andzhelo/DjDoorbell/videos/djdoorbell-reel-a/.thumbnails/v5_7471ff6d567243b7_d42bf97ba044923f_jpeg_source_index.html_1080x1920_1080x1920_1793446295449_0.00.jpg

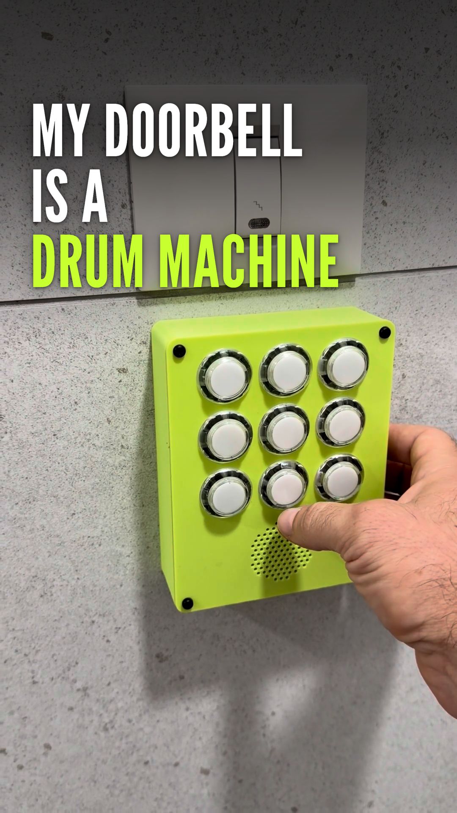
videos/djdoorbell-reel-a/.thumbnails/v5_7471ff6d567243b7_d42bf97ba044923f_jpeg_source_index.html_1080x1920_1080x1920_1793446295449_0.00.jpg
