andzhelo/DjDoorbell/docs/HANDOFF.md

# Handoff — build day

Written 2026-10-03, at the end of the first working session. Read this after
CLAUDE.md. It says where the project stands and what happens next, step by
step.

**How to work with the owner:** explain every step in plain words — what to
plug in, which command to run, what they should see. Hardware and CAD terms
need a one-line explanation the first time. When they ask for a short answer,
give one sentence. They plan to finish in **one day** and record it as a
**public video tutorial**, so steps should be filmable and in a sensible order.

---

## Where we are

| Area | State |
|---|---|
| Sounds | Done. 11 files in `data/raw/`, generated by `tools/make_samples.py`. Loop is exactly 64 grid steps (no drift). |
| Audio engine | Done, `lib/engine/`. Matches `tools/simulator.py` to 0.5 LSB. Repeat variant: pad 3 twice fast = open hat. |
| Outside bench firmware | Done, `src/main.cpp` (env `outside`). 9 pads, LED flash in row colour, quantised playback. Verified on the S3 with 5 buttons. |
| Link test | **PASSED** 2026-10-03, door closed, channel 1: unicast 99.987 %, longest gap 106 ms, RSSI −71 dBm. Log: `docs/linktest-2026-10-03.log`. |
| Two-board firmware | Written and **working on the bench**: presses play on both units on the same beat, sync within ±0.5 ms, zero late presses. Long-press pad 5 = chime (`11_chime`). WiFi + OTA on both (`*_ota` envs). Quiet hours done 2026-11-05 (web page card). Phone notification (ntfy) done 2026-11-05. Not yet done: replay. |
| Inside volume knob | **On** (`-DDJ_VOLUME_POT=1` in the `inside` env since 2026-11-05). 9 mm RV09 pot, ends on 3V3/GND, wiper GPIO34; verified on wall power. |
| Enclosure | Shell printed. Faceplate v2 (40 mm speaker) printing now. Sources in `cad/`. |
| Parts | All arrived. |
| Tests | `pio test -e native`: 30/30 (incl. a two-board sync simulation at ±300 ppm). |
| Repo | Public on GitHub. No LICENSE or README yet. |

## Facts a new session needs

- S3 serial port when on its **UART** USB socket: `/dev/cu.usbmodem5C834152081` (fourth S3, MAC B8:1F:3F:C3:D0:30, flashed 2026-10-30, healthy; this is the door board). Older: `/dev/cu.usbmodem5CF70341171` (second S3, see below). Third S3 `/dev/cu.usbmodem5CF70340961` (MAC 44:BD:8D:68:04:74) is parked with the pixel test on it. (second S3, MAC 44:BD:8D:68:03:A0 — USB power path damaged, ran from the buck; probably killed 2026-10-21 by 12 V on GPIO13 during the WS2815 build, see CLAUDE.md Power; new S3s on order; the first dead board was `/dev/cu.usbmodem5C843177861`). A third S3 is needed; see CLAUDE.md Power for the bench findings (outside amp dead, LED chain data path unverified).
  (a CH343 bridge). The other socket (native USB) flashes but shows no log.
  The WROOM's port: `/dev/cu.usbserial-0001` (CP2102).
- **WROOM bench quirk:** after a program closes its serial port, the WROOM
  sits in a reset loop (CP2102 auto-reset lines + macOS) and is silent until
  the port is reopened or USB is replugged. Keep a logger holding the port
  during bench tests. Irrelevant once installed (no USB).
- **WROOM screw-terminal adapter:** the terminal printed "GND" next to 5V is
  the board's **CMD** pin (flash). Use the GND between P13/P12 or bottom-right.
  All other labels match. Pins pushed into the terminals need the screws
  tightened.
- The first inside MAX98357A was **dead** (4.8 V at VIN, I2S running, no
  sound); replaced. Mark it.
- WiFi: use the main network `Andzhelo` (2.4 GHz on channel 1, "Smart
  Wi-Fi" on). The guest network refuses the S3 and isolates clients, so the
  Mac cannot reach the boards. Each board is refused once before joining
  (harmless). The S3 hears the router weakly (−87 dBm on the desk): OTA to
  the outside unit may need USB instead.
- **Power board simplified** (see CLAUDE.md Protection): fuse + 470 µF + buck
  only. Diagram and perfboard layout: https://claude.ai/artifact/9pFNN78vK4oG96C1DbZBHt
  Outside buck is set to 5.0 V and verified. Two earlier "dead" bucks were a
  broken adapter wire, not dead — they are probably fine.
- LED chain: soldered, passed the pixel test (needed the SS34 on its lead).
- Bench aids: type `1`-`9` / `c` on the S3 serial port to press a pad /
  chime; on the WROOM `c` = chime, `f` = full volume toggle. S3 BOOT = pad 5.
- To read serial without resetting or holding the port, the previous
  session used pyserial from PlatformIO's Python
  (`$(head -1 $(which pio) | sed 's/^#!//')`) with `dtr=False, rts=False`
  set before `open()`. Close the user's `pio device monitor` first or the
  port is busy.
- PlatformIO and OpenSCAD (snapshot cask) are installed via Homebrew.
  Homebrew's `python3` shadows the system one; the simulator needs
  `/usr/bin/python3` (it has numpy).
- Inside unit partitions: `min_spiffs.csv` (two 1.9 MB slots, for OTA). The
  next USB flash of the WROOM installs this layout.
- LED colours are gamma-corrected (`gamma8`) and capped at 40 %.
- Images from the owner often arrive as `.heic` in `~/Downloads`; convert
  with `sips -s format jpeg`. Video: extract frames with `ffmpeg`.

---

## Build day, in order

### 0. Faceplate (printing now)
When done: snap one button into a hole, slide one LED strip piece into a
channel, put the speaker in the ring, set the plate on the shell. All four
should fit without force.

### 1. Link test — the gate (~30 min)
Nothing gets soldered until this passes.

1. Plug **both** boards into the laptop. S3 on its UART socket.
2. Flash:
   ```sh
   pio run -e linktest_outside -t upload --upload-port /dev/cu.usbmodem5C843177861
   pio run -e linktest_inside  -t upload --upload-port <WROOM port>
   ```
3. Desk check, 30 s: open the inside monitor
   (`pio device monitor -p <WROOM port>`). Expect `outside unit found`,
   then a line every 10 s with near-zero loss. The S3's onboard LED is green.
4. Real test: WROOM stays on the laptop near the chime box. S3 goes
   outside where the button will be, on a phone power bank. **Close the
   door.** LED must be green.
5. Wait 10 minutes. The laptop prints `LINK TEST RESULT` and `OVERALL: PASS`
   or `FAIL`.
   - Pass criteria: unicast delivery ≥ 99.9 %, no silence ≥ 1 s,
     average RSSI ≥ −80 dBm.
6. **If FAIL:** stop and discuss. Options in order: move the inside board
   closer to the door, external-antenna board, or the Cat6 pull from
   CLAUDE.md (check for conduit).
7. Open question: the test uses WiFi channel 1. Once the inside unit joins
   home WiFi, ESP-NOW must run on the **router's** channel. Ask the owner
   for it; if known, rerun with `-DLINK_CHANNEL=<n>` added to both
   linktest envs.

### 2. Two-board firmware (Claude writes it; owner solders meanwhile)
Must-have for the day, in this order:
1. Outside: send each pad press to the inside unit over ESP-NOW (unicast),
   packet = pad index + grid position. Broadcast grid phase every bar.
2. Inside: same engine and samples, plays the events quantised to the same
   grid, locks to the outside's phase. A lost packet must not break sync.
3. Inside: volume pot on GPIO34 (ADC1).
4. Long-press centre pad (pad 5) = plain 2-second chime, both units.
5. WiFi + OTA on both units. Credentials in `include/secrets.h`
   (gitignored; template `include/secrets.example.h`).

Nice-to-have, if time allows: quiet hours (NTP, cut outside volume after
22:00), phone notification (MQTT or Home Assistant webhook), performance
replay.

Keep every new piece testable on the host like `lib/engine/`, and add
native tests.

### 3. Solder and assemble — outside unit
Do these **in this order**:

1. **LED strips first, on the bench.** Cut three 3-LED pieces at the copper
   pads. Solder them as one chain: row 1 out (right end) → row 2 in (left
   end) → row 3. Arrows left to right. Flash `outside_pixeltest`
   (`pio run -e outside_pixeltest -t upload`) and watch red/green/blue walk
   through all 9. Only then slide them into the channels.
2. **Set the buck converter to 5.0 V before connecting anything to it.**
   Feed it 12 V, turn its small screw while measuring the output with a
   meter. A wrong voltage here destroys the boards.
3. **Protection board** (perfboard), between the wall wires and the buck:
   wall + → fuse (500 mA — check the cap, the bag said 0313001, which may
   be 1 A) → SS34 (stripe towards the buck) → buck IN+.
   Across IN+/GND: SMAJ15A (stripe to +) and 470 µF (stripe to GND).
   Buck OUT+ → second SS34 (stripe away from buck) → **5 V rail** (~4.6 V).
4. 5 V rail → S3 5V pin, amp VIN, LED strip 5V. 1000 µF across 5V/GND at
   the first LED (stripe to GND).
5. Buttons: every COM to GND; NO to GPIO 4, 5, 6, 7, 15, 16, 17, 18, 8
   (pads 1–9, reading order).
6. Amp: BCLK→12, LRC→11, DIN→10, GAIN→VIN, SD not connected. Speaker on
   OUT+/OUT−, never to GND.
7. LED data: GPIO13 → 330 Ω → row 1 DIN.
8. Heat-set inserts into the 4 shell corners (soldering iron, slow and
   straight). Boards on the shell floor with foam tape. Plate on with
   4× M3×8 countersunk screws.

Inside unit wiring (in the existing chime box): amp BCLK→26, LRC→25,
DIN→22, GAIN not connected; pot ends to 3V3/GND, wiper → GPIO34. Power:
IRM-10-12 → 12 V → (a) the pair to the door, (b) buck at 5.0 V → SS34 →
WROOM 5V and amp VIN.

### 4. Install — **breaker off**
1. Breaker off. Confirm 0 V with the meter at the chime box before
   touching anything.
2. Remove the old chime and 8 V transformer. Mount the IRM-10-12 in its
   place. This is the 230 V step: if in any doubt, an electrician does it.
3. Mark which of the two brown wires is +12 V.
4. Breaker on. Measure 12 V DC on the pair **at the door, before**
   connecting the outside unit. Check polarity.
5. Connect the outside unit; screw the shell to the Nisko wall box
   (horizontal slots take 52–68 mm screw spacing).

### 5. Tune and publish
- Volume (inside pot; outside amp is already at its quiet gain), LED
  brightness, quantise on/off by ear.
- Before announcing the repo: add `LICENSE` (proposed: MIT for code,
  CC BY 4.0 for `cad/` and `data/` — confirm with the owner), a
  `README.md` for humans (what, photos/video, parts, wiring, build, flash,
  print), and a 230 V safety note. CLAUDE.md is for Claude, not readers.

---

## Open decisions

- Router WiFi channel: settled — both units join the router, so ESP-NOW
  follows its channel automatically.
- Fuse rating: confirm 500 mA.
- Idle LED behaviour: dark, dim breathing, or slow colour drift.
- Nisko wall-box screw spacing is assumed (60 mm); the slots allow 52–68.

## Tutorial (2026-10-31)

Public write-up of the whole build, with photos, clips, CAD renders and the
lessons: https://claude.ai/artifact/5YxCbNBJak7X3pdnc8jSSZ (private until shared
from its Share menu). Source page and media were generated from this repo's
`videos/djdoorbell/assets/` and `cad/preview/`.
