andzhelo/DjDoorbell/videos/djdoorbell/STORYBOARD.md

---
format: 1920x1080 (index.html) · 1080x1920 (reel.html)
duration: 159s · 39s
message: "A doorbell you play, not press"
arc: Hook (the finished pad) → The wall → Bench → Link test → Enclosure → Soldering → Assembly → At the wall → To be continued
audience: makers / DIY electronics
mode: autonomous
---

Both cuts are monolithic compositions (no sub-compositions): a flat video track cut on
the 124.016 BPM grid of the doorbell's own loop, chapter cards / captions as timed
overlays, and a persistent HUD (3x3 pad grid + 16-step bar) that pulses on the beat.
Generated by `generate.py`; edit the shot lists there or edit the HTML in Studio.

Motion citations: cold-open title and chapter cards = `kinetic-beat-slam`
(one BEAT/BAR grid drives every onset, distinct entrance per phrase: blur-slam /
side-snap / rise). Reel captions = `waterfall-entry`-style snap with a bar sweep.
HUD = finite per-beat `fromTo` pulses (no infinite repeats). Photos = Ken Burns on
an inner `<img>` (creator-editing-recipes → Pan / Ken Burns). Transitions: hard cuts on
the beat (percussive montage); chapter cards wipe in/out with `clip-path` — the wipe
is the exit. Final scene fades to black (allowed).

## Frame 1 — Cold open
- scene: Finished lime pad face-up; "DJ DOORBELL" slams on bar 1
- duration: 7.7s
- transition_in: cut
- status: animated
- src: index.html

## Frame 2 — 01 The wall
- scene: Old Nisko button, 230 V box, 8.18 V AC meter, transformer, pulling the old button
- duration: 15.5s
- status: animated
- src: index.html

## Frame 3 — 02 The bench
- scene: Parts, arcade button, S3 soldering, LED strip, breadboard, terminal board, buck
- duration: 19.4s
- status: animated
- src: index.html

## Frame 4 — 03 The gate
- scene: Link test: laptop on the floor, door closes, pad pressed outside
- duration: 15.5s
- status: animated
- src: index.html

## Frame 5 — 04 Enclosure
- scene: Coupon, shell, pressing buttons into the faceplate, nine buttons
- duration: 19.4s
- status: animated
- src: index.html

## Frame 6 — 05 Soldering
- scene: Power board, button wiring with smoke, two time-lapses, strip wiring
- duration: 34.8s
- status: animated
- src: index.html

## Frame 7 — 06 Assembly
- scene: Shell meets faceplate, pad face up, hero rotation
- duration: 19.4s
- status: animated
- src: index.html

## Frame 8 — 07 The wall, again
- scene: Bare wires in the wall, shell held against the wall
- duration: 15.5s
- status: animated
- src: index.html

## Frame 9 — End card
- scene: TO BE CONTINUED · Part 2: install day · GitHub URL; chime; fade
- duration: 11.6s
- status: animated
- src: index.html

## Reel — 10 shots × 2 bars
- scene: hero → old button → S3 → LEDs → door test → time-lapse → overhead → nine buttons → hero spin → at the wall
- duration: 38.7s
- status: animated
- src: reel.html
