andzhelo/DjDoorbell/(commit log)

2026-09-21 Scaffold PlatformIO project
    platformio.ini from CLAUDE.md verbatim, plus a native env for host unit
    tests and default_envs so a bare 'pio run' builds only the two boards.
    pioarduino stable installs Arduino-ESP32 core 3.3.12 (ESP_I2S API).
2026-09-21 Add audio engine and native quantiser tests
    Port of Engine from tools/simulator.py: looping bed, one retriggerable
    voice per pad, clock = samples rendered, strictly-next 16th quantise,
    same gains and tanh soft limit. Hardware-free so it runs on the host.
    Tests prove presses at arbitrary offsets and arbitrary render block
    sizes fire exactly on 2667-sample boundaries, both via the fire callback
    and in the rendered audio.
2026-09-21 Bench firmware: I2S out, embedded samples, BOOT button
    samples.{h,cpp} wrap the embed_files symbols as {data, len} and check
    2-byte alignment at boot. main.cpp logs chip/flash/PSRAM, runs the
    engine in an I2S-paced task on core 1 (clock = samples written), and
    queues 04_stab_am on each BOOT (GPIO0) press. Per-board I2S pins from
    the CLAUDE.md pin maps; mono written to both L and R slots.
2026-09-21 Log fire events from loop() instead of the audio task
    ets_printf on the audio task raced the Serial driver for UART0 and
    dropped characters. The fire callback now posts (pad, at) to a queue
    and loop() prints with Serial — the same hand-off LEDs and ESP-NOW
    will use. Also logs the full 64-bit sample count.
2026-09-21 Add pixel chain test env
    outside_pixeltest walks one pixel through 1-9 in red, green, then blue
    at 20% on GPIO13, logging each step. For checking the bench-soldered
    chain before any pixel is seated. The bench firmware is compiled out
    under PIXEL_TEST; outside/inside builds are unchanged.
2026-09-22 Add pad debouncer with native tests
    Accepts a level only after it holds for N ms, rejecting contact bounce
    and short spikes on long button wires. Hardware-free like the engine.
    Claude-Session: https://claude.ai/code/session_018jYxG8x3cBTVkduSsdmtGW
2026-09-22 Outside unit: nine pads, pixel flash, quantised playback
    Pads on GPIO 4 5 6 7 15 16 17 18 8 (INPUT_PULLUP, active low, 5 ms
    debounce). Each press logs its pad number and queues its sample; when
    it fires on the grid, that pad's pixel flashes in its row colour at the
    40% cap, delayed ~71 ms to match the I2S output latency. Inside unit
    keeps the BOOT-button bench test.
    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
2026-09-22 Gamma-correct pad row colours
    The row hex values are sRGB; WS2812 PWM is linear, so sent raw they
    over-drive green/blue and amber reads as warm white through a frosted
    cap. Decode with gamma8 before applying the 40% cap, and log the
    resulting LED values at boot.
    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
    [main.cpp]
2026-09-23 Regenerate sample set on the quantise grid
    The loop was 170709 samples (true 124 BPM) while the grid is 2667, so
    the quantiser drifted 21 samples per loop — 7.4 ms/min, audible after a
    few minutes. The generator now defines tempo from the grid (124.016 BPM)
    and the loop is exactly 64 x 2667 samples.
    Also: sub moved A1 -> A2 with more drive (55 Hz is inaudible on both
    speakers), bar 4 drops the last kick and adds a clap flam, Em stab
    replaced by F (i-III-VI instead of three chords sharing notes), and an
    open-hat variant (10_hat_open) for the repeat-variant feature. Generator
    and padboard now read/write data/raw; previews go to data/preview
    (ignored). Sample set is 557 KB.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
    [samples.cpp, samples.h]
2026-09-23 Engine: repeat variants and 1.0 limiter ceiling
    A press on the same pad within two grid steps plays the pad's variant
    if it has one; the firmware maps pad 3's repeat to the open hat. The
    limiter ceiling drops from 1.15 to 1.0: the old curve exceeded full
    scale at bed + two aligned hits and was hard-clipped. simulator.py
    mirrors both; the engine is sample-exact against it, including the
    variant path. Native tests: 13/13.
    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
2026-09-26 Add parametric OpenSCAD enclosure for the outside unit
    params.scad holds every dimension (MEASURE marks placeholders awaiting
    calipers). Parts: hole-size coupon (24.0/24.2/24.4), 100x145 faceplate
    with 3x3 pad grid, speaker grille and locating rib, and the shell with
    M3 insert bosses, wall-box slots, wire entry and board standoffs.
    render.sh exports STL + PNG via the CLI; output is gitignored.
    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
    [coupon.scad, faceplate.scad, params.scad, shell.scad]
2026-09-26 Coupon: 36 mm tiles so labels clear the hole
    On 30 mm tiles the last digit of 24.2/24.4 ran into the hole edge in
    the slicer. The larger tile puts the hole's lowest point 5.9 mm from
    the edge, clear of the label row, and gives a realistic margin around
    the 27.5 mm flange. Labels now read 24.0 rather than 24.
    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
    [coupon.scad]
2026-09-26 Coupon: 4 hole sizes x 2 panel thicknesses
    The real buttons are XW-OBSC (OBSC-24 clones): hole spec 24 +-0.1, no
    lamp holder, switch clipped under the clear body. FDM holes print
    undersize, so the range moves up to 24.0-24.6, and each is printed at
    2.5 and 3.0 mm to find the panel the snap tabs actually grip. README
    notes the LED now has to sit beside the switch block on a carrier.
    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
    [coupon.scad, params.scad]
2026-09-26 cad/README: switch is integral to the button body
    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
2026-09-26 params: button depths from the ruler photo
    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
    [params.scad]
2026-09-29 Faceplate and shell ready to print
    Coupon result 24.0/2.5 sets the hole and panel thickness. Shell depth
    from the measured button (terminals + 8 mm for wire bends), wall-box
    slots made horizontal to take 52-68 mm lug spacing, standoffs dropped
    (DevKitC-1 has no holes), and side-wall ledges added for the future LED
    carrier. The plate's locating rib is notched around the corner bosses;
    assembly.scad renders plate-on-shell and an interference check, which
    is empty.
    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
    [assembly.scad, faceplate.scad, params.scad, shell.scad]
2026-09-29 Side-lit buttons: LED strip channels on the faceplate back
    The switch block covers almost the whole button base, so under-lighting
    is out; a hand test confirmed side lighting through the clear body
    works. Each row gets an uncut 3-LED strip piece (100 mm) standing on
    edge in a channel just below it, LEDs up into the bodies. The plate and
    shell widen to 114 mm so the 100 mm strip fits inside the rib, and the
    unused carrier ledges are removed from the shell. assembly.scad now
    checks shell/plate, buttons/plate+strips and strips/plate+shell; all
    are empty, and deliberately clashing variants are caught.
    Claude-Session: https://claude.ai/code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
    [assembly.scad, faceplate.scad, params.scad, shell.scad]
2026-10-02 40 mm speaker; CLAUDE.md records hardware and enclosure decisions
    The speaker arrived at 40 mm, not 23.5: the faceplate gets a 42.8 mm
    ring and a 34 mm grille, centred between the bottom rib and the row-3
    strip fin, with asserts that fail the render on a clash. The shell is
    unchanged.
    CLAUDE.md now reflects what was decided since the spec was written:
    the real buttons (XW-OBSC, no lamp holder), side-lit rows with 3-LED
    strip pieces, the 114x145 enclosure, the glass fuse substitute, and
    build status, so a fresh session starts from the current state.
    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
    [faceplate.scad, params.scad]
2026-10-02 Inside unit: min_spiffs partitions for OTA updates
    huge_app.csv has a single 3 MB app slot, so the installed chime could
    only be updated over USB. min_spiffs.csv gives two 1.9 MB slots; the
    inside firmware with all samples is 880 KB (44.7%). CLAUDE.md updated
    with the reason and the 1.9 MB budget.
    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
2026-10-02 Phase 3 link test firmware (ESP-NOW gate)
    Outside sends 50 packets/s, alternating raw broadcast (no retries, raw
    radio loss) and unicast with MAC retries (what the doorbell will use),
    carrying its own delivery/echo/round-trip counters; its RGB LED is
    green while echoes arrive. Inside counts loss per kind from sequence
    numbers, RSSI and the longest silence, echoes every packet, prints a
    line every 10 s and a PASS/FAIL summary after 10 minutes: unicast
    delivery >= 99.9 %, no silence >= 1 s, average RSSI >= -80 dBm.
    Envs linktest_outside / linktest_inside; normal builds unchanged.
    Claude-Session: https://claude.ai/code/session_018jYxG8x3c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
    [link_test.cpp, main.cpp]
2026-10-03 Add build-day handoff
    docs/HANDOFF.md: current state, environment facts (ports, tooling),
    and the build day in order — link test, two-board firmware, soldering
    with polarity and the buck-voltage step, install with the breaker off,
    publishing. CLAUDE.md points to it.
    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
2026-10-03 Link test: score only the test window; passed through the door
    The sender's counters run across an inside reset, so failures from the
    inside reboot (~24 at 50 packets/s) were counted and would fail the
    0.1 % limit by themselves. The inside unit now subtracts the sender's
    counters from the first packet of the test. Also print the real STA MAC
    (WiFi.macAddress() read zeros before the radio started).
    Result 2026-10-03, door closed, channel 1: unicast 99.987 %, longest
    silence 106 ms, RSSI -71 dBm avg -> PASS. Log in docs/.
    Claude-Session: https://claude.ai/code/session_01L9EFyzyXBH3xgxpsxS9h4c
2026-10-03 Two-board firmware: inside follows the outside's grid over ESP-NOW
    Outside leads: every press goes to the inside unit (unicast, MAC retries
    plus two resends) with the musical position it sounds at; bed state goes
    10x/s while playing, 1x/s idle. Every packet carries the leader's
    position, so any packet can start or correct the follower.
    Inside follows 30 ms behind so a press always arrives before it is due,
    starts its bed at the leader's position, and locks to it by rendering one
    sample more or fewer per block when the filtered error leaves a 0.5 ms
    band (jump only past 50 ms). Simulated at +-300 ppm clock error with
    +-5 ms timing noise: worst 2.3 ms, every press on the leader's beat.
    Engin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
2026-10-03 Bench aids: type 1-9 / c on the outside serial port, BOOT = pad 5
    Status lines show the measured I2S rate (averaged since boot). First
    hardware run: presses reach the inside unit and fire on the same beat
    (identical sample spacing on both), sync error within +-10 samples,
    no late presses, no jumps. Drop the ADC attenuation call that logged an
    error (11 dB is already the default).
    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
2026-10-03 Inside: volume knob off by default (DJ_VOLUME_POT), fixed volume
    The bench pot read 0 V on GPIO34 whatever its position, which muted the
    inside unit. With DJ_VOLUME_POT=0 (default for now) the unit plays at
    kFixedVolumePct and ignores GPIO34; -DDJ_VOLUME_POT=1 brings the knob
    back. With the knob on, its reading is logged when it moves; 'f' on the
    serial port forces full volume, 'c' plays the chime.
    Verified on hardware: S3 pads play on both units.
    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
2026-10-03 Handoff: link test passed, two-board firmware on the bench, bench findings
    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
2026-10-03 CLAUDE.md: next step is soldering
    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
2026-10-06 Power board simplified: fuse + 470uF + buck, no SMD protection
    The SS34s and SMAJ15A were too hard to hand-solder on perfboard and none
    is critical. Recorded the costs (no reverse-polarity or USB back-feed
    protection) and the rules that replace them. LED chain passed the pixel
    test with an SS34 on its +5V lead; outside buck set to 5.0 V.
    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
2026-10-10 Outside: map pads to LEDs as built (rows 1 and 3 swapped)
    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
2026-10-10 CLAUDE.md: MP1584 trimmer is reversed; note the over-voltage incident
    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
2026-10-10 CLAUDE.md: outside S3 confirmed dead after over-voltage
    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
2026-10-19 Video: first-draft YouTube build montage and Instagram reel (HyperFrames)
    Two HyperFrames projects under videos/: djdoorbell (16:9, 2:39) and
    djdoorbell-reel (9:16, 39 s), both generated from videos/djdoorbell/generate.py
    with every cut on the doorbell loop's 124.016 BPM grid. Footage, renders and
    caches are gitignored; sources come from ~/Desktop/djdorbel_videos.
2026-10-19 Outside: 'd' serial command dumps raw pad levels; pixel test streams data and parks I2S pins
    - main.cpp: serial 'd' prints every pad GPIO and BOOT level for wiring checks.
    - pixel_test.cpp: resend each frame for the whole step so a meter on GPIO13
    reads ~0.5 V average (proves the board drives the chain); hold GPIO10-12
    low so an attached MAX98357A shuts down instead of roaring on pickup.
    Bench 2026-10-19 on the replacement S3: pads, I2S and pixel data all verified
    at the board; outside MAX98357A confirmed dead (spare plays); LED chain still
    unresponsive, first strip / data wire suspect.
    Claude-Session: https://claude.ai/code/sess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
2026-10-20 Docs: second S3 dead (regulator burned on a 3V3-powered strip test); amp dead; bench findings
    Claude-Session: https://claude.ai/code/session_01RBA2nmUtWJEMsY4GqEHdTW
2026-10-20 Docs: boards 2 and 3 alive on buck power (USB power path damaged); board 2 is the door board
    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
2026-10-21 CLAUDE.md: outside unit plays on board 2; 12 V WS2815 strip replaces the dead 5 V chain
    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
2026-10-21 Outside: pad->LED map as a per-pad table, 9 LEDs in reading order; docs: WS2815 attempt abandoned, board 2 likely dead
    The 12 V WS2815 chain worked as a 3-LED test but the full 9-LED build most
    likely put 12 V on GPIO13 (its +12V pad neighbours DI). Back to a 5 V 30/m
    WS2812B strip with the SS34 and the 330R series resistor. kPixelsOf keeps the
    per-pad table form so a backwards-chained row is a three-number edit.
    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
2026-10-30 Docs: fourth S3 flashed (port + MAC), 5 V strip arrived
    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
2026-10-30 CLAUDE.md: board 4 verified with the new strip; 5Vin jumper quirk; buck replaced
    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
2026-10-31 CLAUDE.md: outside unit fully verified on buck power (board 4, amp, 9 pads, 9 LEDs)
    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
2026-10-31 Outside: middle LED piece chained right-to-left, swap pads 4/6 in kPixelsOf
    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
2026-10-31 CLAUDE.md: IRM-10-12 installed; board 4 died on box close (mechanical short)
    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
2026-10-31 Docs: board 5 flashed with outside (port, MAC, IP); board 4 dead
    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
2026-10-31 CLAUDE.md: outside unit closed and working on board 5 after insulating all bare metal
    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
2026-10-31 CLAUDE.md: inside unit on wall power
    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
2026-10-31 CAD: inside unit enclosure (plate with 3" grille + shell for WROOM/buck/amp), parametric, MEASURE placeholders
    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
2026-10-31 CAD inside: mains compartment for the IRM-10-12 + connectors, partition, shell/fit checks
    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
2026-10-31 Reel A: vertical Instagram cut of the DJ Doorbell build, music from the doorbell's own engine
    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
2026-10-31 Reel A v4: clean start, maker centred in the soldering bar, levelled sound
    Hook and loop tail start at 8.03 s of the door clip (after a sound tail that
    opened v3 on a burst). The soldering bar uses the near-square clip with the
    maker centred. Hook audio gets a volume lane and a 90 Hz high-pass, bars 2-3
    of the generated track are filled out, chime sits under the music, and the
    delivery transcode is limited to -14.4 LUFS.
    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
2026-11-01 Inside enclosure: square 78 mm speaker on insert bosses, volume-knob hole
    Speaker per the listing: 78 x 78 frame, holes on an 84 mm diagonal, 45 mm
    magnet, 68 mm opening. The retaining ring becomes four standoff bosses with
    M3 inserts; the knob hole is at the bottom right over the board bay. Both
    assembly checks are empty. Depth still assumed 36 mm.
    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
2026-11-02 Inside enclosure: landscape layout, 130 x 126 mm
    Owner wants no side over 130 mm. Speaker bottom left, board column on the
    right (WROOM lengthwise, buck, amp, knob at the top), mains compartment as a
    strip across the top left over the wall box behind an L-shaped partition
    with the 12 V notch. Both assembly checks empty; check="open" renders the
    layout without the plate.
    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
2026-11-02 CAD notes: inside enclosure landscape layout
    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
2026-11-02 Inside plate: socket for the 9 mm RV09 pot instead of a 16 mm bushing hole
    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
2026-11-05 Inside unit installed: volume knob on by default
    Knob verified on wall power 2026-11-05; inside env builds with
    -DDJ_VOLUME_POT=1 so the next OTA keeps it. Notes updated.
    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
2026-11-05 Phone notification through ntfy, settings on the pad page
    Outside unit posts to an ntfy topic when a performance starts and when
    the plain chime rings, from a separate task so the pads never wait on
    TLS. Settings in NVS; GET /notify, /notify/set, /notify/test; a card on
    the pad page with a test button. Verified end to end against ntfy.sh.
    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
2026-11-07 Outside unit: retry WiFi every 2 min after giving up
    After a power cut the unit boots minutes before the router, gave up WiFi
    after 20 s and stayed off it until the next reboot. Now it tries again
    every 2 min while the pad is idle; ESP-NOW keeps working meanwhile.
    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
